SUZZIEDEVELOPS/Human-Motion-Prediction-Wearable-Hardware-System/(commit log)

2026-05-05 Create Raspberry Pi
2026-05-05 Update Raspberry Pi
